nervalo88/ESP8266_INTEX_SPA/Hack_Pictures/AnnotatesPics.pptx

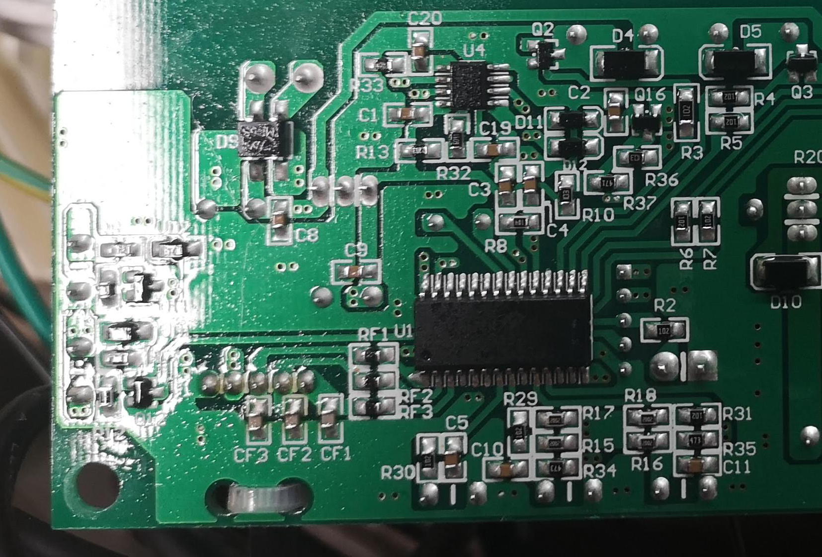
[picture p3: figure]

5V outputs
R3 : Water pump state (filtration)
R4 : Jet pump state (bubbles)
R5 : Heater state

## Slide 2

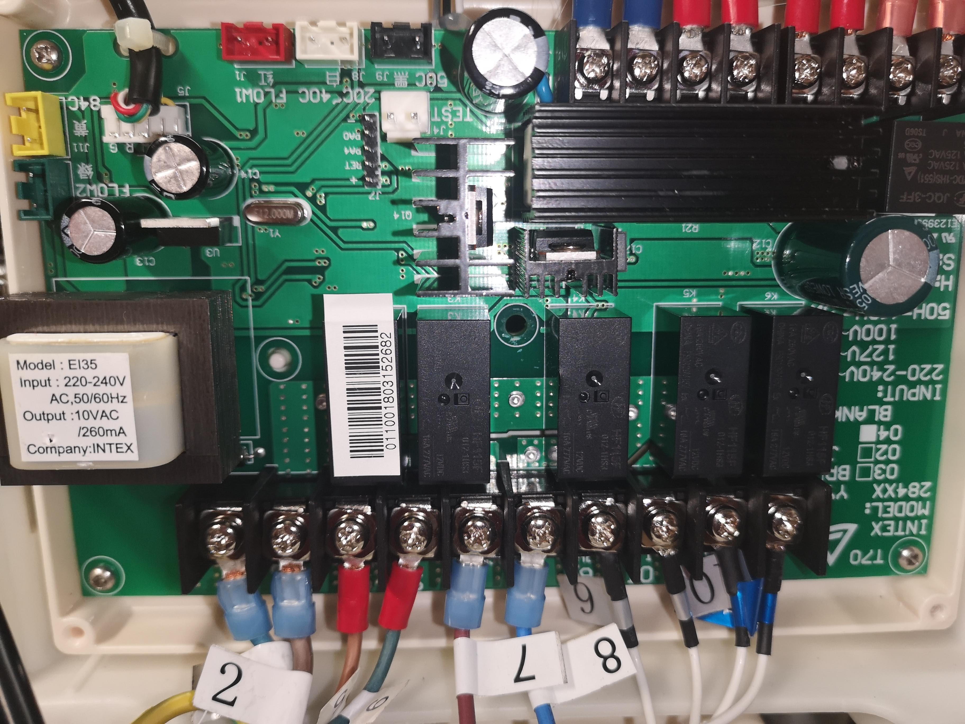
[picture p4: figure]

ESP8266 power supply location

GND

+5V

## Slide 3

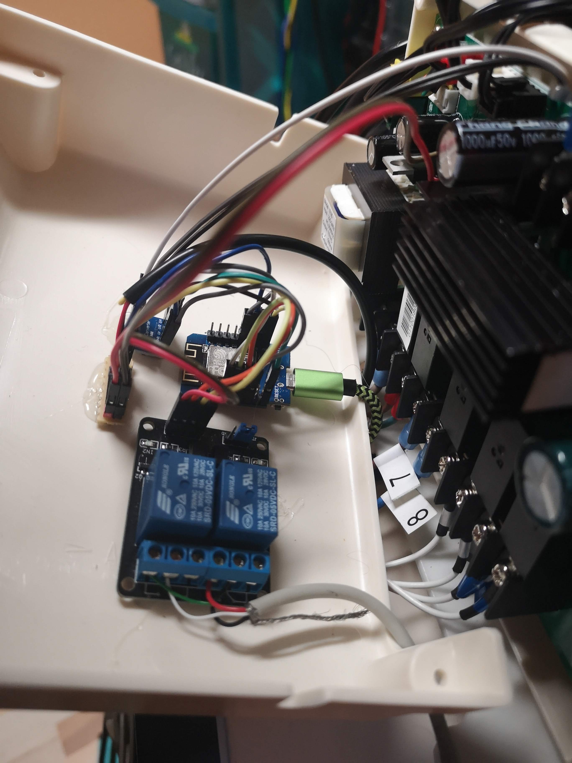
[picture p5: figure]

To main PCB outputs

3.3v/5v level converter

Supply headers

+5V

GND

To DS18B20 (temp. Sensor)

ESP 8266 (Wemos D1 mini)

2x relay board

To control PCB
