nervalo88/ESP8266_INTEX_SPA/Hack_Pictures/IMG_20191214_220646.jpg

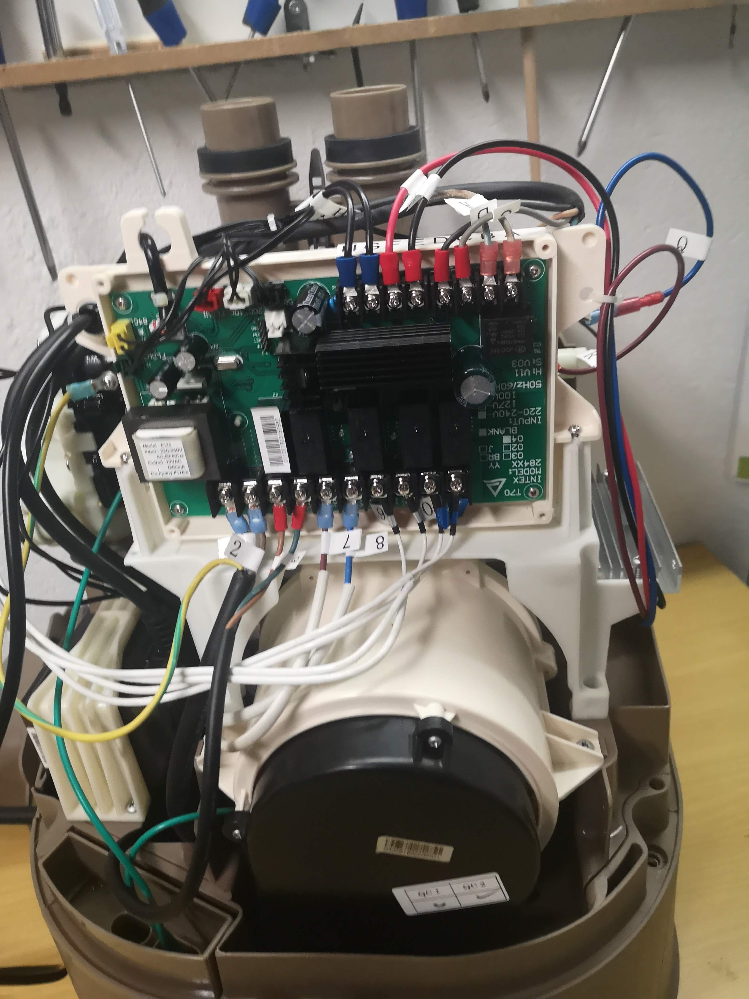
Hack_Pictures/IMG_20191214_220646.jpg
