nervalo88/ESP8266_INTEX_SPA/Hack_Pictures/IMG_20191214_220652.jpg

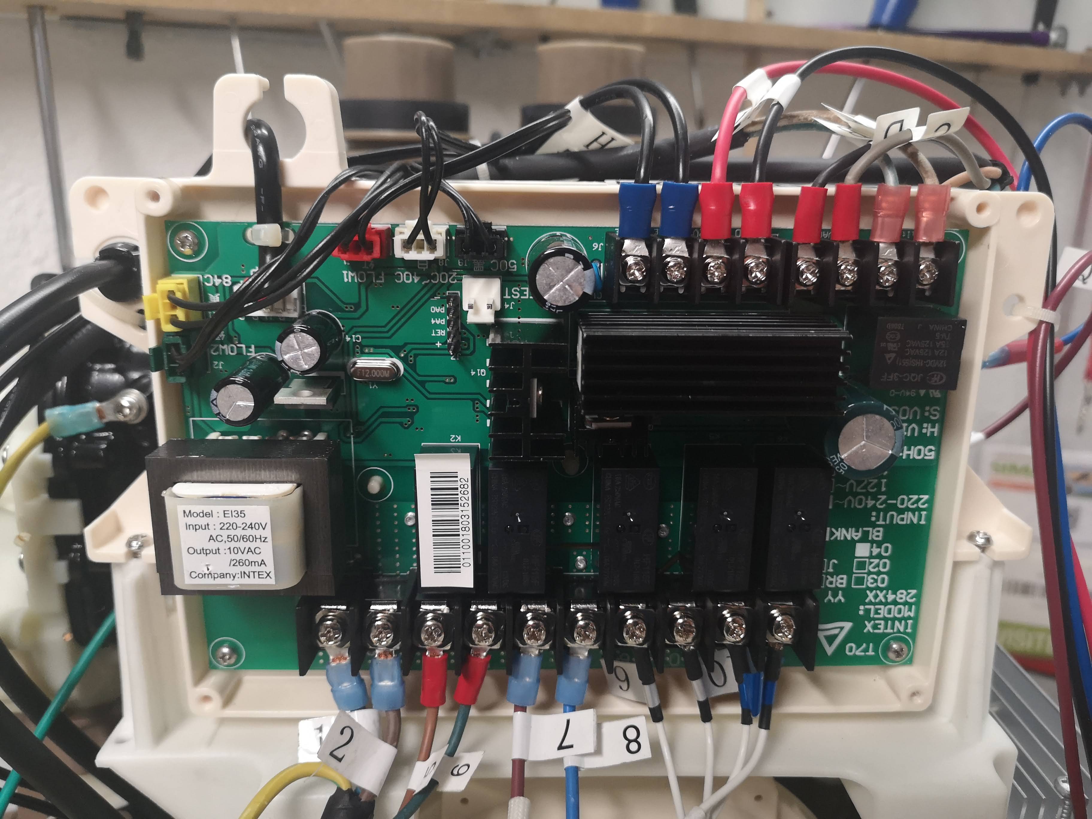
Hack_Pictures/IMG_20191214_220652.jpg
