nervalo88/ESP8266_INTEX_SPA/Hack_Pictures/IMG_20191214_225507.jpg

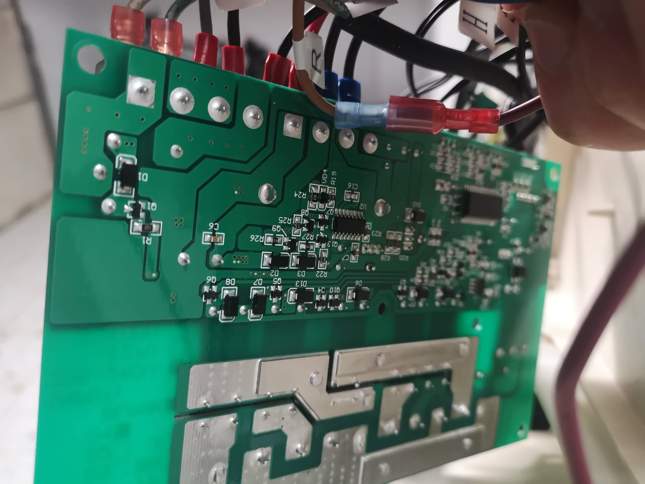
Hack_Pictures/IMG_20191214_225507.jpg
