nervalo88/ESP8266_INTEX_SPA/Hack_Pictures/IMG_20191215_152524.jpg

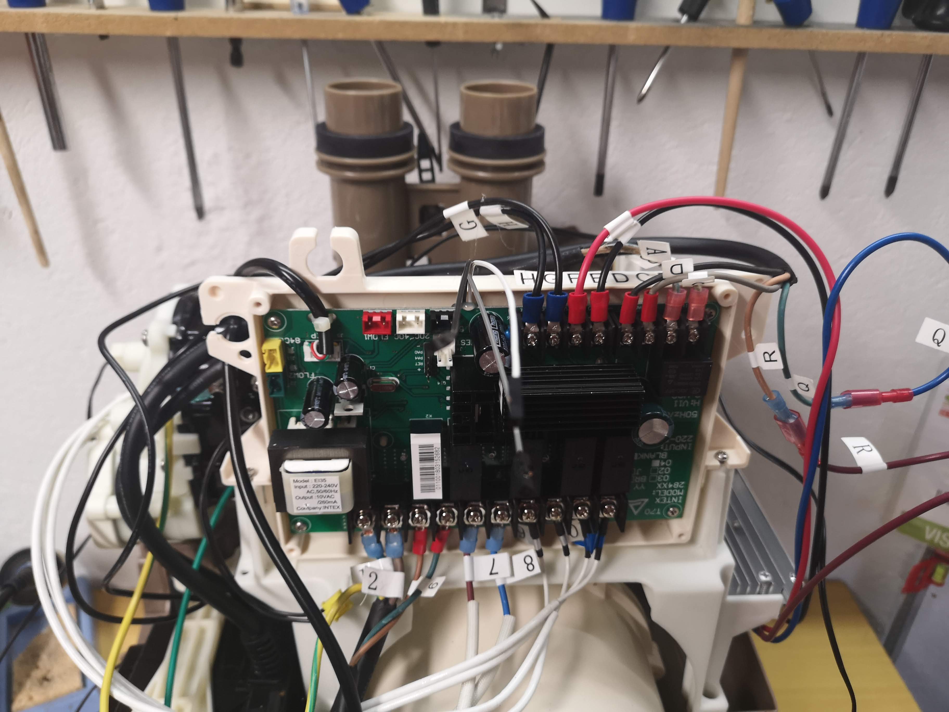
Hack_Pictures/IMG_20191215_152524.jpg
