nervalo88/ESP8266_INTEX_SPA/Hack_Pictures/IMG_20191218_083958.jpg

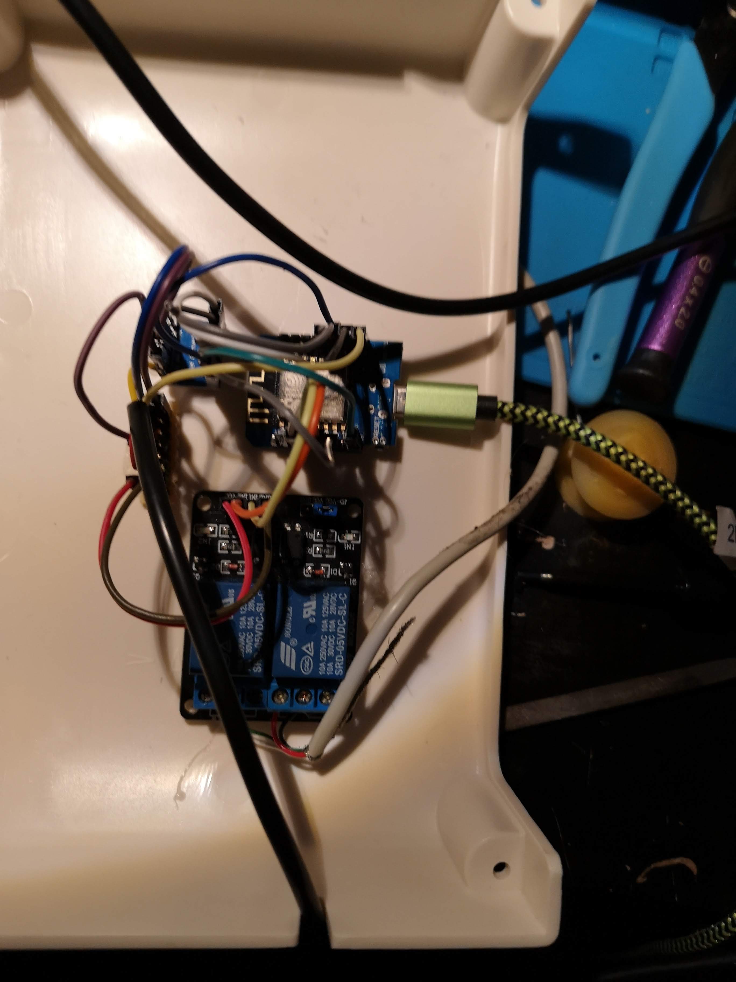
Hack_Pictures/IMG_20191218_083958.jpg
