nervalo88/ESP8266_INTEX_SPA/Hack_Pictures/IMG_20191223_141913.jpg

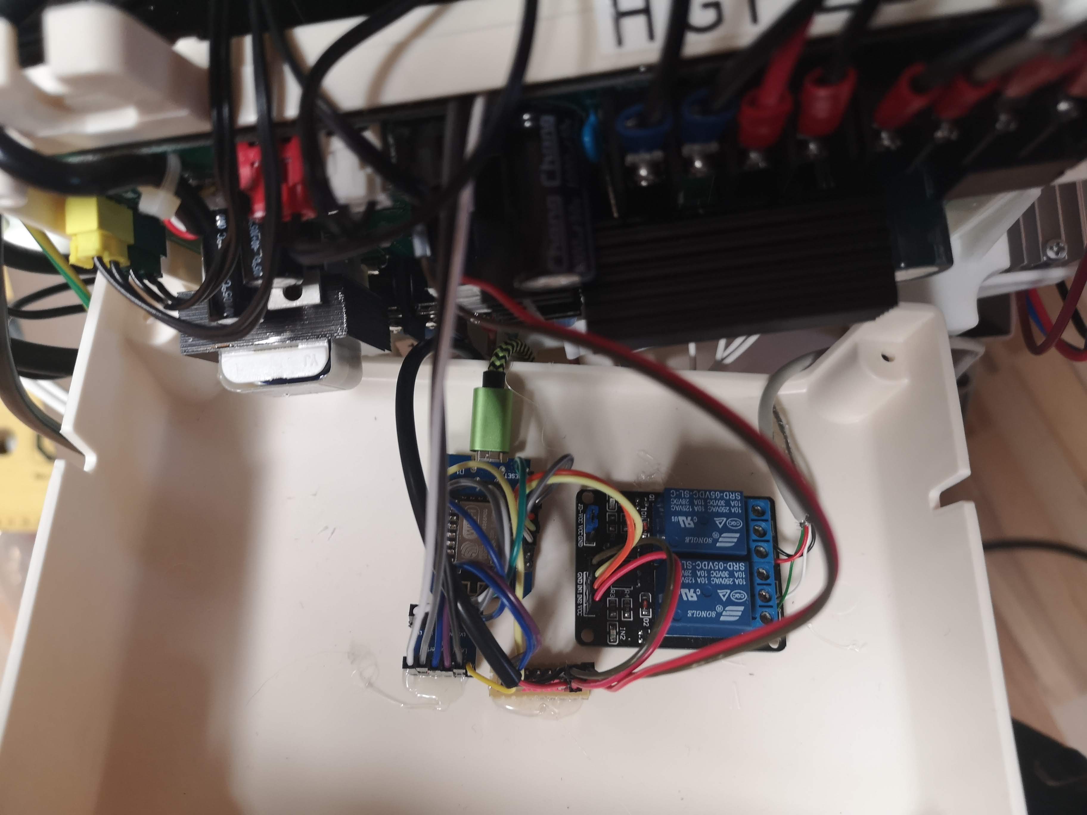
Hack_Pictures/IMG_20191223_141913.jpg
