nervalo88/ESP8266_INTEX_SPA/(commit log)

2019-12-22 1st commin
    [Classeur1.xlsx]
2019-12-23 Berta test release Pin changed for filtering & jet pump root page updated
